CreativeLau/Function_Generator_STC/V0.3/circuit_V0.3.pdf

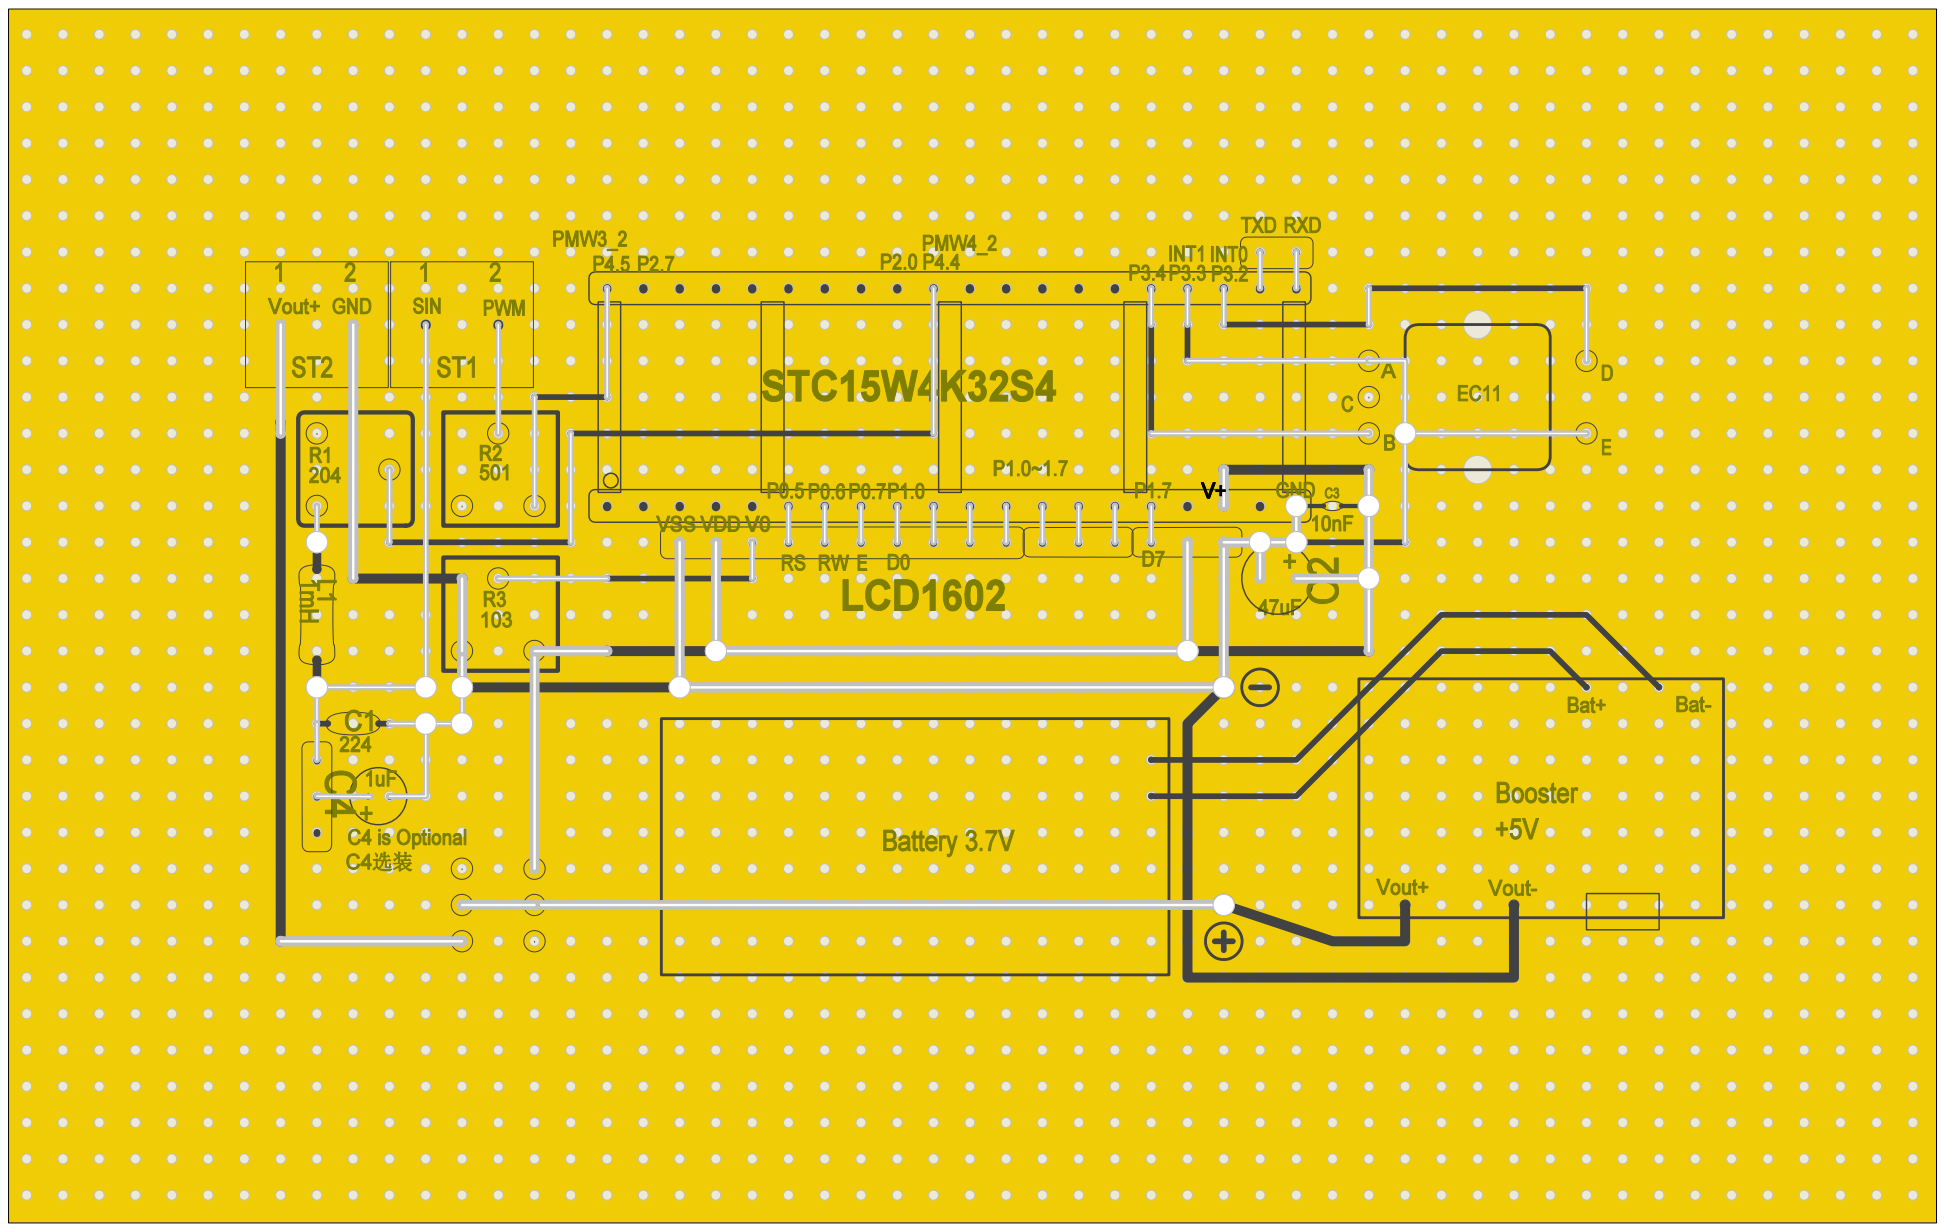
[picture p4: page 1]
