CreativeLau/Function_Generator_STC/V0.3/Scheme_V0.3.pdf

## LCD1602

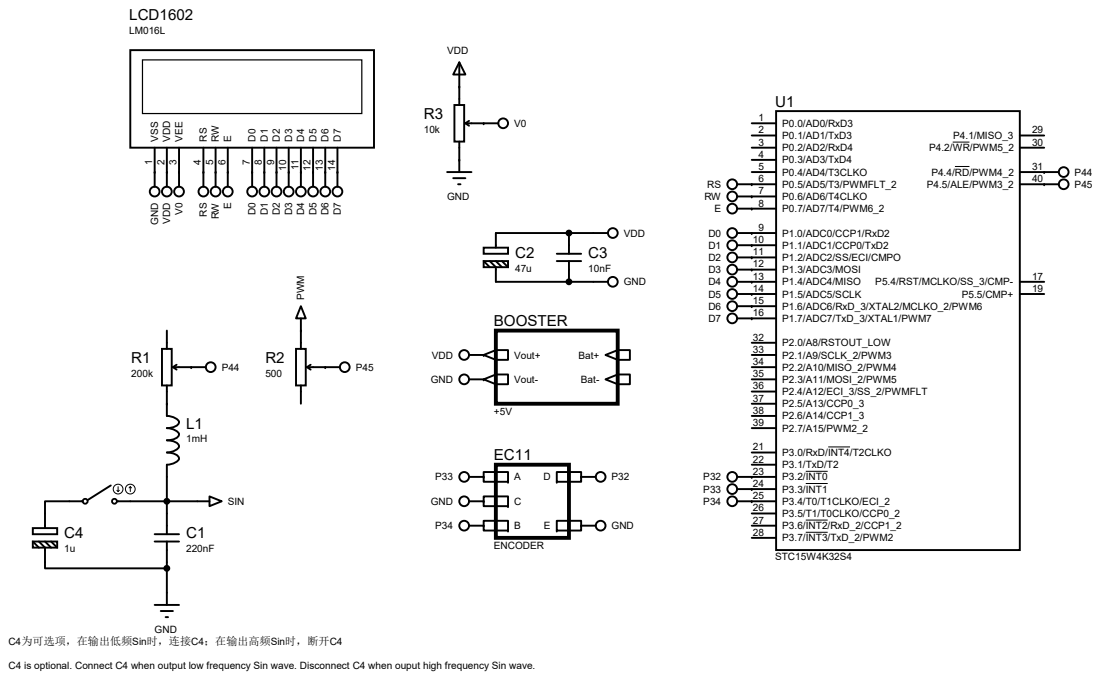
[picture p5: page 1]

C4 is optional. Connect C4 when output low frequency Sin wave. Disconnect C4 when ouput high frequency Sin wave.
