CreativeLau/Function_Generator_STC/(list of files, drawings)

Other design files:
V0.3/Scheme_V0.3.pdsprj
