CreativeLau/Function_Generator_STC/V0.3/Code_V0.3.2/T_SineTable.h

unsigned char code T_SinTable[] = {
    75,
    75,
    76,
    76,
    77,
    77,
    78,
    78,
    79,
    79,
    80,
    80,
    81,
    81,
    82,
    82,
    83,
    83,
    83,
    84,
    84,
    85,
    85,
    86,
    86,
    87,
    87,
    88,
    88,
    89,
    89,
    90,
    90,
    90,
    91,
    91,
    92,
    92,
    93,
    93,
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

};
